fieldkit/naturalist/hardware/sensor-board/fk-naturalist-sensors.kicad_pcb

## KiCad design hardware/sensor-board/fk-naturalist-sensors.kicad_pcb (2019-03-14)

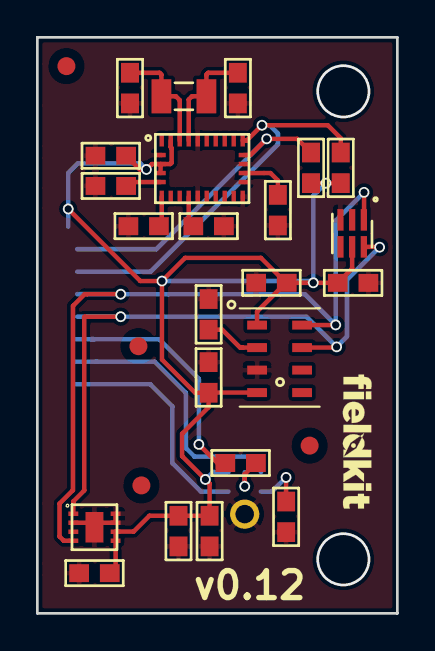
[picture p1: board fk-naturalist-sensors.kicad_pcb from above]

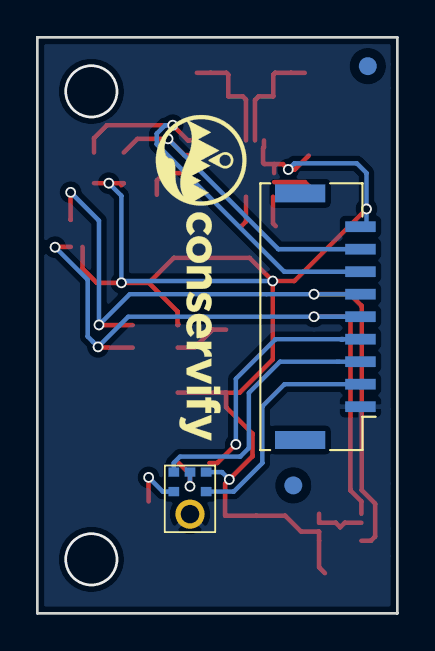
[picture p2: board fk-naturalist-sensors.kicad_pcb from below]

Board: 2 copper layers, 20.0 x 32.0 mm, 31 parts (4 on the bottom side), 18 nets.

Parts:
C1, C2, C3, C9, C10: 100nF; CAP-0603
C4, C6: 1uF; CAP-0603
C5: 10uF; CAP-0603
C7: 220pF; CAP-0603
C8, C11: 22pF; CAP-0603
J1: CONN_01x09; Molex_CLIK-Mate_502382-0970_1x09_P1.25mm_Vertical
M1, M2, M5, M6, M9, M10: FIDUCIAL; FIDUCIAL-1MM
R1, R3, R4, R5: 10K; RES-0603
R2: 68R; RES-0603
R6, R7: 4.7K; RES-0603
U1: MPL3115A2; DFN-8-1EP_5x2.55mm_Pitch1.25mm_98ASA002260D
U2: SHT31; SHT3x
U3: SPH0645; SPH0645LM4H-B
U4: TSL2591
U5: BNO055
Y1: FC-135; ABS07

Connections:
3V3: C2.1, C3.1, C4.1, C5.1, C6.1, C7.1, C9.2, J1.9, R6.2, R7.2, U1.1, U1.4, U2.5, U2.6, U3.5, U4.5, U5.3, U5.4, U5.28
/I2S_BCLK: J1.2, U3.4
/I2S_DATA: J1.4, R2.2
/I2S_WS: J1.3, U3.1
/SCL: J1.6, U1.8, U2.4, U4.1
/SCL2: J1.8, R7.1, U5.19
/SDA: J1.5, U1.7, U2.1, U4.6
/SDA2: J1.7, R6.1, U5.20
GND: C1.2, C2.2, C3.2, C4.2, C5.2, C6.2, C7.2, C8.2, C9.1, C10.1, C11.2, J1.1, R1.1, R3.2, R4.2, R5.2, U1.3, U2.2, U2.7, U2.8, U2.PAD, U3.3, U4.3, U5.2, U5.10, U5.15, U5.16, U5.18, U5.25
unnamed: C1.1, U1.2
unnamed: C8.1, U5.27, Y1.1
unnamed: C10.2, U5.9
unnamed: C11.1, U5.26, Y1.2
unnamed: R1.2, U3.2
unnamed: R2.1, U3.6
unnamed: R3.1, U5.17
unnamed: R4.1, U5.6
unnamed: R5.1, U5.5
