fieldkit/naturalist/firmware/main/readings.h

#ifndef FK_NATURALIST_READINGS_H_INCLUDED
#define FK_NATURALIST_READINGS_H_INCLUDED

#include <Adafruit_Sensor.h>
#include <Adafruit_BNO055.h>
#include <Adafruit_TSL2561_U.h>
#include <Adafruit_MPL3115A2.h>
#include <Adafruit_TSL2591.h>
#include <Adafruit_SHT31.h>

#include <AudioAnalyzer.h>
#include <AudioIn.h>
#include <AmplitudeAnalyzer.h>
#include <AudioInI2S.h>

#include "state_services.h"

#include "task.h"
#include "core_state.h"
#include "two_wire.h"

namespace fk {

class NaturalistReadings {
private:
    TwoWireBus bno055Wire_{ Wire4and3 };
    Adafruit_SHT31 sht31Sensor_;
    Adafruit_MPL3115A2 mpl3115a2Sensor_;
    Adafruit_TSL2591 tsl2591Sensor_{ 2591 };
    Adafruit_BNO055 bnoSensor_{ 55, BNO055_ADDRESS_A, &Wire4and3 };
    AmplitudeAnalyzer amplitudeAnalyzer_;
    bool hasBno055_{ false };
    bool hasAudioAnalyzer_{ false };
    bool initialized_{ false };
    Leds *leds_;

public:
    void setup(Leds *leds);
    TaskEval task(CoreState &state);

};

class TakeNaturalistReadings : public MainServicesState {
private:
    NaturalistReadings readings_;

public:
    const char *name() const override {
        return "TakeNaturalistReadings";
    }

public:
    void setup();
    void task() override;

};

}

#endif
