fieldkit/naturalist/(commit log)

2017-12-28 Expose Wire1 and Wire3 on header. Got rid of unnecessary jumpers.
    [fk-naturalist.kicad_pcb, fk-naturalist.sch]
2017-12-28 Just tweaking the locations of things.
    [fk-naturalist.kicad_pcb]
2017-12-29 Adding D30 and D31 to header.
    [fk-naturalist.kicad_pcb, fk-naturalist.sch]
2018-01-12 Starting on the combined coreless board. Schematic is... done hopefully.
    This includes the change to the new I2S chip.
    [fk-naturalist.kicad_pcb, fk-naturalist.sch]
2018-01-13 Working on the new PCB layout.
    [fk-naturalist.kicad_pcb, fk-naturalist.sch]
2018-01-14 Everything is connected, time to cleanup.
    [fk-naturalist.kicad_pcb]
2018-01-15 Some power fills, cleaning up warnings.
    [fk-naturalist.kicad_pcb]
2018-01-16 Breakaway part for sensors.
    [fk-naturalist.kicad_pcb, fk-naturalist.sch]
2018-01-16 Remove some bad shapes.
    [fk-naturalist.kicad_pcb]
2018-01-16 New breakaway approach. Cleaning some things up.
    [fk-naturalist.kicad_pcb, fk-naturalist.sch]
2018-02-15 Add RTC related part numbers.
    [fk-naturalist.sch]
2018-02-15 Fix TSL2591 footprint.
    [fk-naturalist.sch]
2018-02-15 Add legacy voltage regulator, just in case. And a missing resistor.
    [fk-naturalist.kicad_pcb]
2018-02-15 Plotting gerbers.
    [fk-naturalist-B.Cu.gbr, fk-naturalist-B.Mask.gbr, fk-naturalist-B.Paste.gbr, fk-naturalist-B.SilkS.gbr, fk-naturalist-Edge.Cuts.gbr, fk-naturalist-F.Cu.gbr, fk-naturalist-F.Mask.gbr, fk-naturalist-F.Paste.gbr]
2018-03-05 Using key names for sensors. Going to pretty up using metadata.
2018-03-06 Add test firmware for the new integrated board.
2018-03-06 More label/naming cleanup.
    [fk-naturalist.kicad_pcb, fk-naturalist.sch]
2018-03-06 Starting firmware for the consolidated board.
2018-03-06 Don't read BNO055 if it's missing.
    [main.cpp]
2018-03-21 Fix USB footprint with oval drills.
    [fk-naturalist.kicad_pcb, fk-naturalist.sch]
2018-03-21 Moving some parts in from the edge.
    [fk-naturalist.kicad_pcb]
2018-03-21 Nudge some passives away from a sensor.
    [fk-naturalist.kicad_pcb]
2018-03-21 Adding some pin 1 markers.
    [fk-naturalist.kicad_pcb]
2018-03-21 Bump revision.
    [fk-naturalist.kicad_pcb]
2018-03-22 Fix serial flash pin. It's on the "TX_LED" pin. Seems to work there.
    [main.cpp]
2018-03-22 Issue various warnings about PIN_LED_TXL.
    [main.cpp]
2018-03-27 Fixes after changes to firmware-common.
    [main.cpp]
2018-04-04 Invert supervisor/parallel task container.
    [main.cpp]
2018-04-19 Use taskQueue for sensor readings.
2018-05-01 Switch to our RadioHead fork.
2018-05-01 Migrate to arduino-logging.
2018-05-07 Adding peripheral enable NFET.
    [fk-naturalist.kicad_pcb, fk-naturalist.sch]
2018-05-08 Use fkfs to test SD to avoid formatting issues causing false negatives.
    [main.cpp]
2018-05-08 Fix stencil on audio chip and plotting.
    [fk-naturalist-B.Cu.gbr, fk-naturalist-B.Mask.gbr, fk-naturalist-B.Paste.gbr, fk-naturalist-B.SilkS.gbr, fk-naturalist-Edge.Cuts.gbr, fk-naturalist-F.Cu.gbr, fk-naturalist-F.Mask.gbr, fk-naturalist-F.Paste.gbr]
2018-05-11 Dropping module code. No longer relevant.
    [main.cpp, readings.cpp, readings.h]
2018-05-18 Enable peripherals using our new switch.
2018-05-19 Adding some part numbers.
    [fk-naturalist.sch]
2018-05-22 Fix some float narrowing warnings.
    [readings.cpp]
2018-05-22 Enable call trace debugging stuff.
    This required me to add some dependencies to the test firmware.
2018-06-13 Widen gap between USB and SD. Nudge USB out.
    Giovanni recommended we make these changes to ease our enclosure design.
    [fk-naturalist.kicad_pcb, fk-naturalist.sch]
2018-06-13 Preparing to split the PCB into two boards.
    [fk-naturalist-B.Cu.gbr, fk-naturalist-B.Mask.gbr, fk-naturalist-B.Paste.gbr, fk-naturalist-B.SilkS.gbr, fk-naturalist-Edge.Cuts.gbr, fk-naturalist-F.Cu.gbr, fk-naturalist-F.Mask.gbr, fk-naturalist-F.Paste.gbr]
2018-06-13 Add separate sensors PCB.
    [fk-naturalist-sensors.kicad_pcb, fk-naturalist-sensors.sch]
2018-06-13 Remove sensors from main board. Add connector.
    [fk-naturalist.kicad_pcb, fk-naturalist.sch]
2018-06-15 Adding fiducials.
    [fk-naturalist.kicad_pcb, fk-naturalist.sch]
2018-06-15 Adding fiducials to the sensor board.
    [fk-naturalist-sensors.kicad_pcb, fk-naturalist-sensors.sch]
2018-06-15 Using new SPH0645 footprint.
    [fk-naturalist-sensors.kicad_pcb]
2018-06-19 Replot gerbers.
    [fk-naturalist-B.Cu.gbr, fk-naturalist-B.Mask.gbr, fk-naturalist-B.Paste.gbr, fk-naturalist-B.SilkS.gbr, fk-naturalist-Edge.Cuts.gbr, fk-naturalist-F.Cu.gbr, fk-naturalist-F.Mask.gbr, fk-naturalist-F.Paste.gbr]
2018-06-19 Fix traces on MCU and via in pads on some ICs.
    Replot with aux origin on drills.
    [fk-naturalist-B.Cu.gbr, fk-naturalist-B.Mask.gbr, fk-naturalist-B.Paste.gbr, fk-naturalist-B.SilkS.gbr, fk-naturalist-Edge.Cuts.gbr, fk-naturalist-F.Cu.gbr, fk-naturalist-F.Mask.gbr, fk-naturalist-F.Paste.gbr]
2018-06-20 Plot sensor board.
    [fk-naturalist-sensors-B.Cu.gbr, fk-naturalist-sensors-B.Mask.gbr, fk-naturalist-sensors-B.Paste.gbr, fk-naturalist-sensors-B.SilkS.gbr, fk-naturalist-sensors-Edge.Cuts.gbr, fk-naturalist-sensors-F.Cu.gbr, fk-naturalist-sensors-F.Mask.gbr, fk-naturalist-sensors-F.Paste.gbr]
2018-06-25 Add Leds to status ctor.
2018-06-27 Adding fiducials to the bottom.
    [fk-naturalist-sensors.kicad_pcb, fk-naturalist-sensors.sch, fk-naturalist.kicad_pcb, fk-naturalist.sch]
2018-06-27 Fix soldermask clearance on sensor board and plot.
    [fk-naturalist-B.Cu.gbr, fk-naturalist-B.Mask.gbr, fk-naturalist-B.Paste.gbr, fk-naturalist-B.SilkS.gbr, fk-naturalist-Edge.Cuts.gbr, fk-naturalist-F.Cu.gbr, fk-naturalist-F.Mask.gbr, fk-naturalist-F.Paste.gbr]
2018-06-27 Fix solder mask clearances correctly.
    [fk-naturalist-B.Cu.gbr, fk-naturalist-B.Mask.gbr, fk-naturalist-B.Paste.gbr, fk-naturalist-B.SilkS.gbr, fk-naturalist-Edge.Cuts.gbr, fk-naturalist-F.Cu.gbr, fk-naturalist-F.Mask.gbr, fk-naturalist-F.Paste.gbr]
2018-06-27 Adding dimensions.
    [fk-naturalist-sensors.kicad_pcb]
2018-07-08 Use fk_uptime instead of millis.
2018-07-24 Upgrade to Kicad 5. Add SK6812.
    [fk-naturalist-2018-07-23-20-07-15.sch, fk-naturalist-sensors-2018-07-23-20-07-33.sch, fk-naturalist.kicad_pcb]
2018-08-21 Switch to new Arduino CMake module.
2018-08-22 Consistent part values across our schematics.
    [fk-naturalist.sch]
2018-08-22 Part updates.
    [fk-naturalist.sch]
2018-08-23 Move to footprints in our library.
    [fk-naturalist-sensors.kicad_pcb, fk-naturalist-sensors.sch]
2018-08-23 Fix SK6812.
    [fk-naturalist.kicad_pcb, fk-naturalist.sch]
2018-08-24 Main board is now same as fk-core.
    [fk-naturalist-2018-07-23-20-07-15.sch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]
2018-08-24 Fix DRC checks and rescued parts.
    [fk-naturalist-sensors.sch]
2018-08-24 Add BNO055 to sensor board. Larger connector.
    [fk-naturalist-sensors.kicad_pcb, fk-naturalist-sensors.sch]
2018-08-24 Add new 9 pin sensor connector.
    [fk-naturalist.kicad_pcb, fk-naturalist.sch]
2018-08-25 Drop debug here, collides with common now.
    [main.cpp]
2018-08-28 Plot gerbers.
    [fk-naturalist-B.Cu.gbr, fk-naturalist-B.Mask.gbr, fk-naturalist-B.Paste.gbr, fk-naturalist-B.SilkS.gbr, fk-naturalist-Edge.Cuts.gbr, fk-naturalist-F.Cu.gbr, fk-naturalist-F.Mask.gbr, fk-naturalist-F.Paste.gbr]
2018-08-28 Use more compatible FP for flash.
    [fk-naturalist.kicad_pcb, fk-naturalist.sch]
2018-08-28 Consistency in part values
    [fk-naturalist-sensors.sch, fk-naturalist.sch]
2018-08-29 Fit sensor board schematic into frame.
    [fk-naturalist-sensors.sch]
2018-08-29 Set ModuleInfo for FkNat sensors.
2018-08-29 Cleanup schematic wks.
2018-08-29 Rename to avoid collision with function.
    [main.cpp]
2018-08-30 Fix SD landing.
    [fk-naturalist-sensors.sch, fk-naturalist.sch]
2018-08-31 Link to ArduinoSound.
2018-08-31 Initialize sensors during startup.
2018-08-31 Fix name of binary to be like other profiled ones.
    [main.cpp]
2018-09-07 Add some bypass caps on GPS 3v3, see if fix issues are power related.
    [fk-naturalist.kicad_pcb, fk-naturalist.sch]
2018-09-07 Add a bead on the GPS 3v3 supply too.
    [fk-naturalist.kicad_pcb, fk-naturalist.sch]
2018-09-07 Plot and bump version.
    [fk-naturalist-B.Cu.gbr, fk-naturalist-B.Mask.gbr, fk-naturalist-B.Paste.gbr, fk-naturalist-B.SilkS.gbr, fk-naturalist-Edge.Cuts.gbr, fk-naturalist-F.Cu.gbr, fk-naturalist-F.Mask.gbr, fk-naturalist-F.Paste.gbr]
2018-09-20 Fix Rx/Tx on backup GPS.
    [fk-naturalist.kicad_pcb, fk-naturalist.sch]
2018-09-25 Include path hack to get build working on OSX.
    Case insensitive file systems are annoying.
2018-09-26 Pin to newer library versions.
2018-10-09 Label positions for assembly, use better footprints for sensors.
    [fk-naturalist-sensors.kicad_pcb]
2018-10-09 Naturalist module enable pin is A5, D9 is used for I2S.
    [fk-naturalist.kicad_pcb, fk-naturalist.sch]
2019-01-14 Main board is now the same as Core, deleting to avoid confusion.
    [fk-naturalist-B.Cu.gbr, fk-naturalist-B.Mask.gbr, fk-naturalist-B.Paste.gbr, fk-naturalist-B.SilkS.gbr, fk-naturalist-Edge.Cuts.gbr, fk-naturalist-F.Cu.gbr, fk-naturalist-F.Mask.gbr, fk-naturalist-F.Paste.gbr]
2019-01-15 Updating test harness code. Report sample readings.
2019-01-15 Adding pullups to SDA2/SCL2.
    [fk-naturalist-sensors-B.Cu.gbr, fk-naturalist-sensors-B.Mask.gbr, fk-naturalist-sensors-B.Paste.gbr, fk-naturalist-sensors-B.SilkS.gbr, fk-naturalist-sensors-Edge.Cuts.gbr, fk-naturalist-sensors-F.Cu.gbr, fk-naturalist-sensors-F.Mask.gbr, fk-naturalist-sensors-F.Paste.gbr]
2019-01-17 Fix location of a fudicial.
    [fk-naturalist-sensors.kicad_pcb]
2019-02-25 Use ArduinoSound that works with newer SAMD cores.
2019-03-14 Standardized hole diameters, pushed connector away from board edge, and panelized for production.
    [fk-naturalist-sensors-B_Cu.gbr, fk-naturalist-sensors-B_Mask.gbr, fk-naturalist-sensors-B_Paste.gbr, fk-naturalist-sensors-B_SilkS.gbr, fk-naturalist-sensors-Edge_Cuts.gbr, fk-naturalist-sensors-F_Cu.gbr, fk-naturalist-sensors-F_Mask.gbr, fk-naturalist-sensors-F_Paste.gbr]
2019-03-28 Try to initialize sensors a few times. Sometimes doesn't take?
    [readings.cpp]
2019-03-28 Update the LEDs when taking FkNat readings.
2019-05-14 Initialize I2S with the other sensors.
2019-05-16 Better reporting on sensor checks in test firmware.
